koppanybme/rc-plane/media/board_assembled.jpg

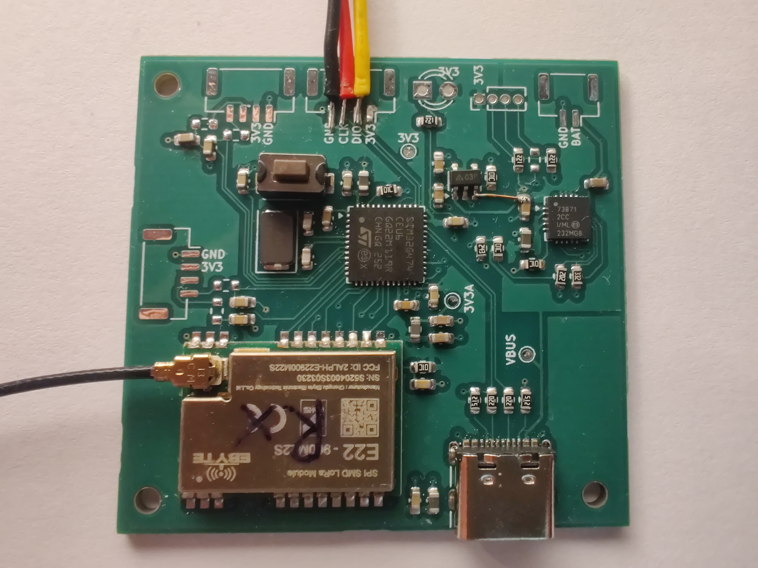
media/board_assembled.jpg
