koppanybme/rc-plane/media/IMG_20250505_191543.jpg

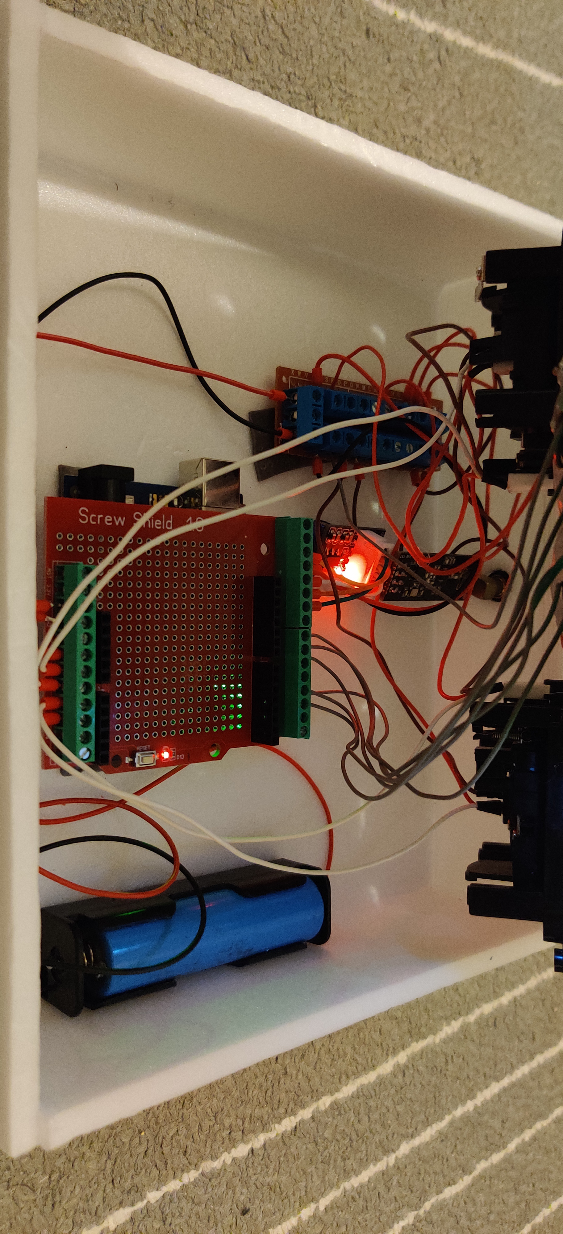
media/IMG_20250505_191543.jpg
