koppanybme/rc-plane/docs/readme.md

Overview

This project aims to create a flight controller for a fixed wing UAV.

History

v0.0 Arduino project using nRF24 (discontinued)
control and telemetry working, tested at 550 m range, video available

v0.1 STM32F103 migration (source code available)
only control implemented, no telemetry

v1.0 STM32G474 SX1262 (CAD files available)
board bringup successful
firmware under developement
