koppanybme/rc-plane/docs/tx_0dbm.png

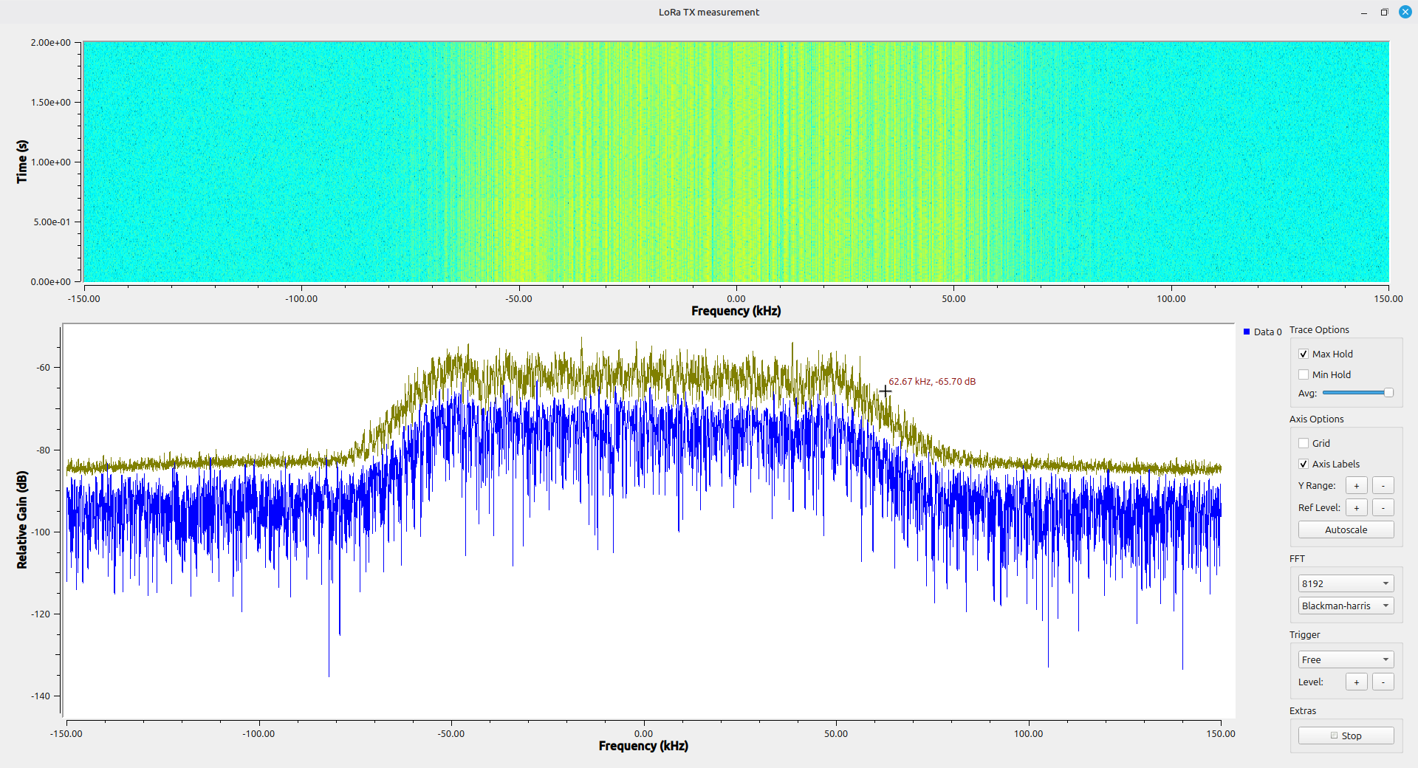
docs/tx_0dbm.png
