koppanybme/rc-plane/media/IMG_20250505_191519.jpg

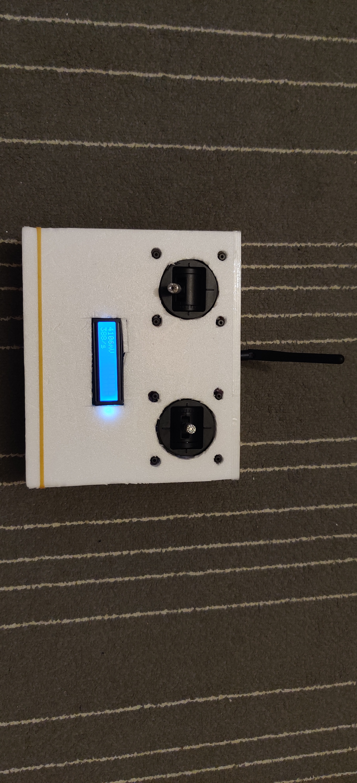
media/IMG_20250505_191519.jpg
