koppanybme/rc-plane/kicad/rc_plane_v1.0/manufacture/rc_plane_v1.0-F_Silkscreen.pdf

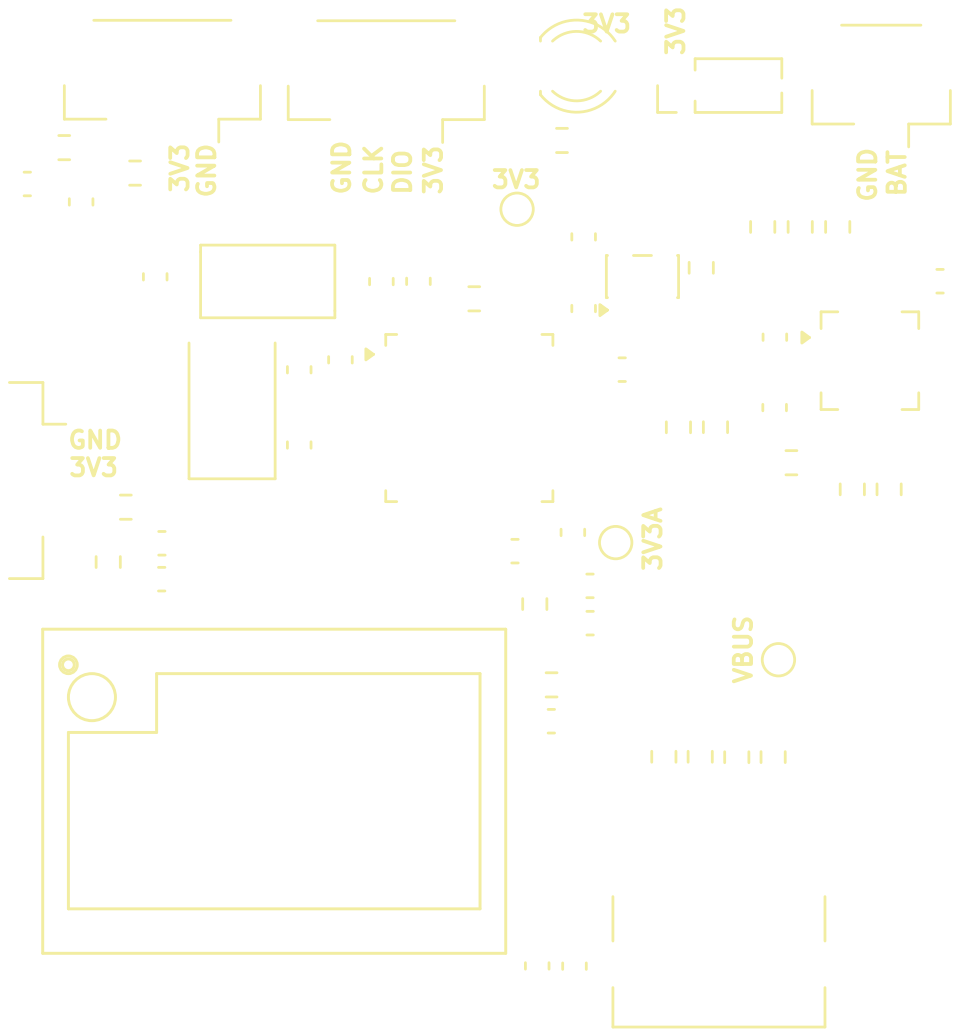
[picture p9: page 1]

3V3 GND DIO BAT GND CLK
