koppanybme/rc-plane/kicad/rc_plane_v1.0/manufacture/rc_plane_v1.0.pdf

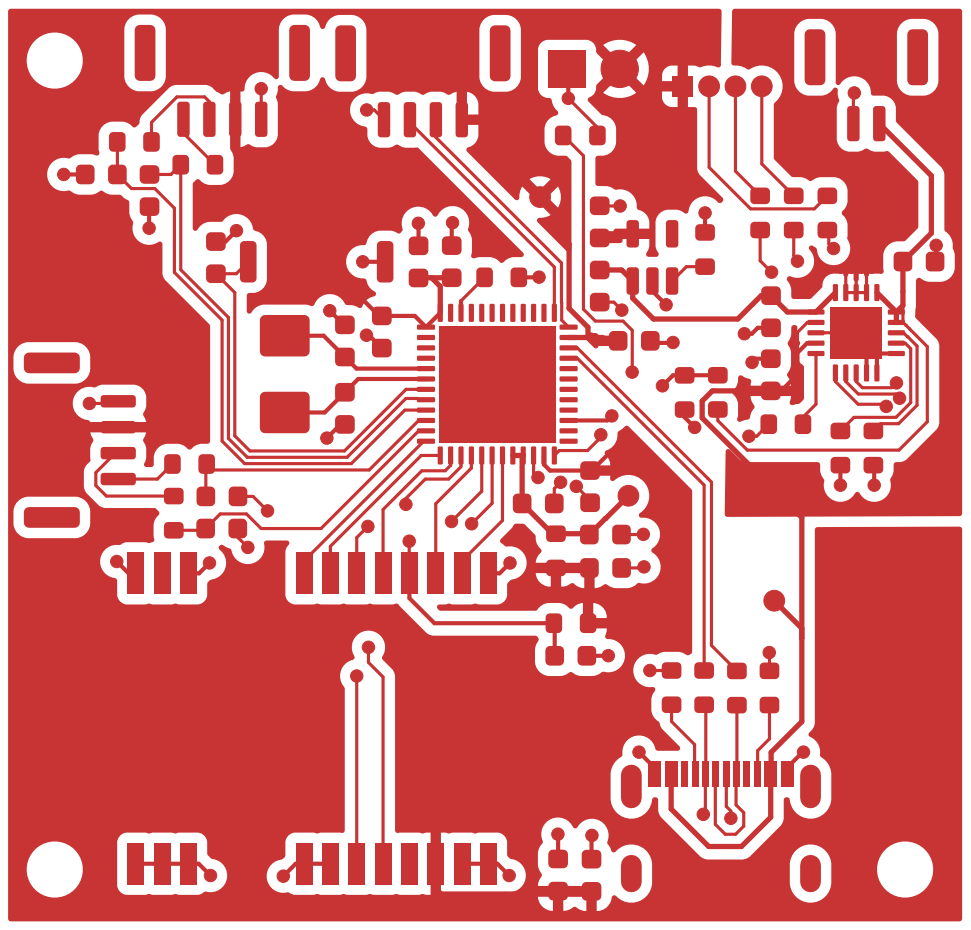
[picture p10: page 1]

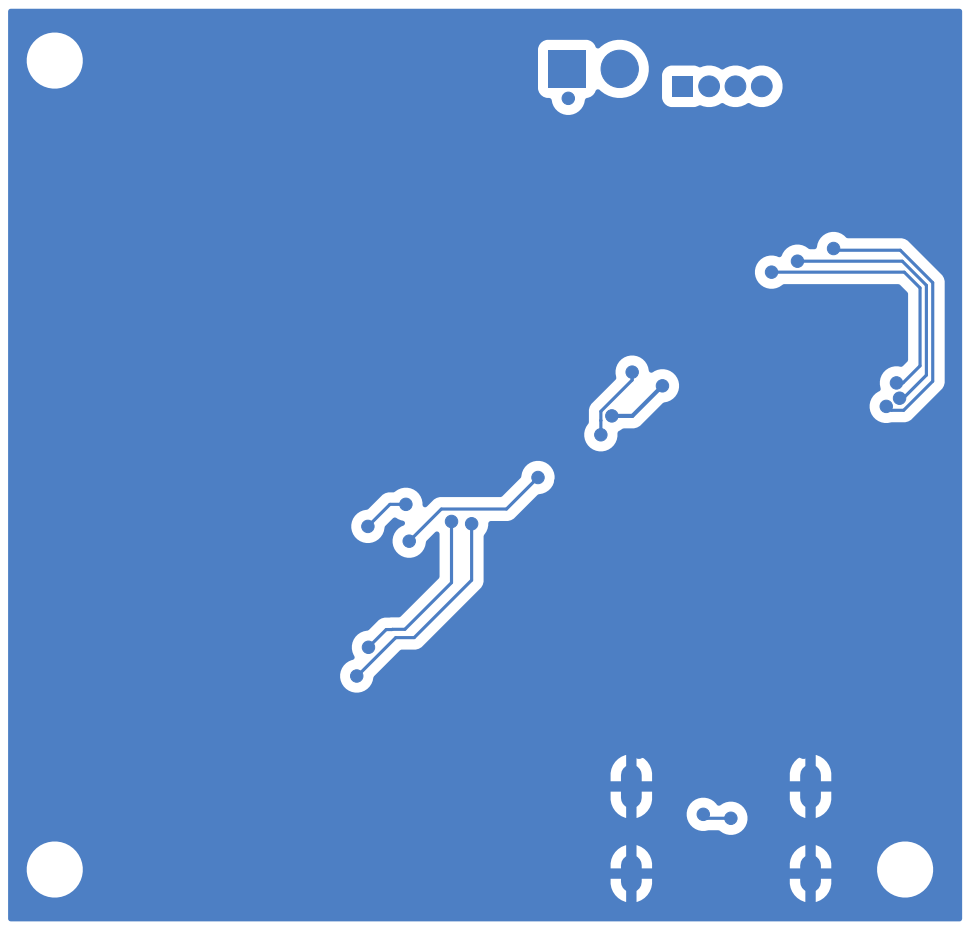
[picture p11: page 2]


3V3 GND DIO BAT GND CLK
