koppanybme/rc-plane/kicad/rc_plane_v1.0/rc_plane_v1.0.kicad_pcb

## KiCad design kicad/rc_plane_v1.0/rc_plane_v1.0.kicad_pcb (2026-07-08)

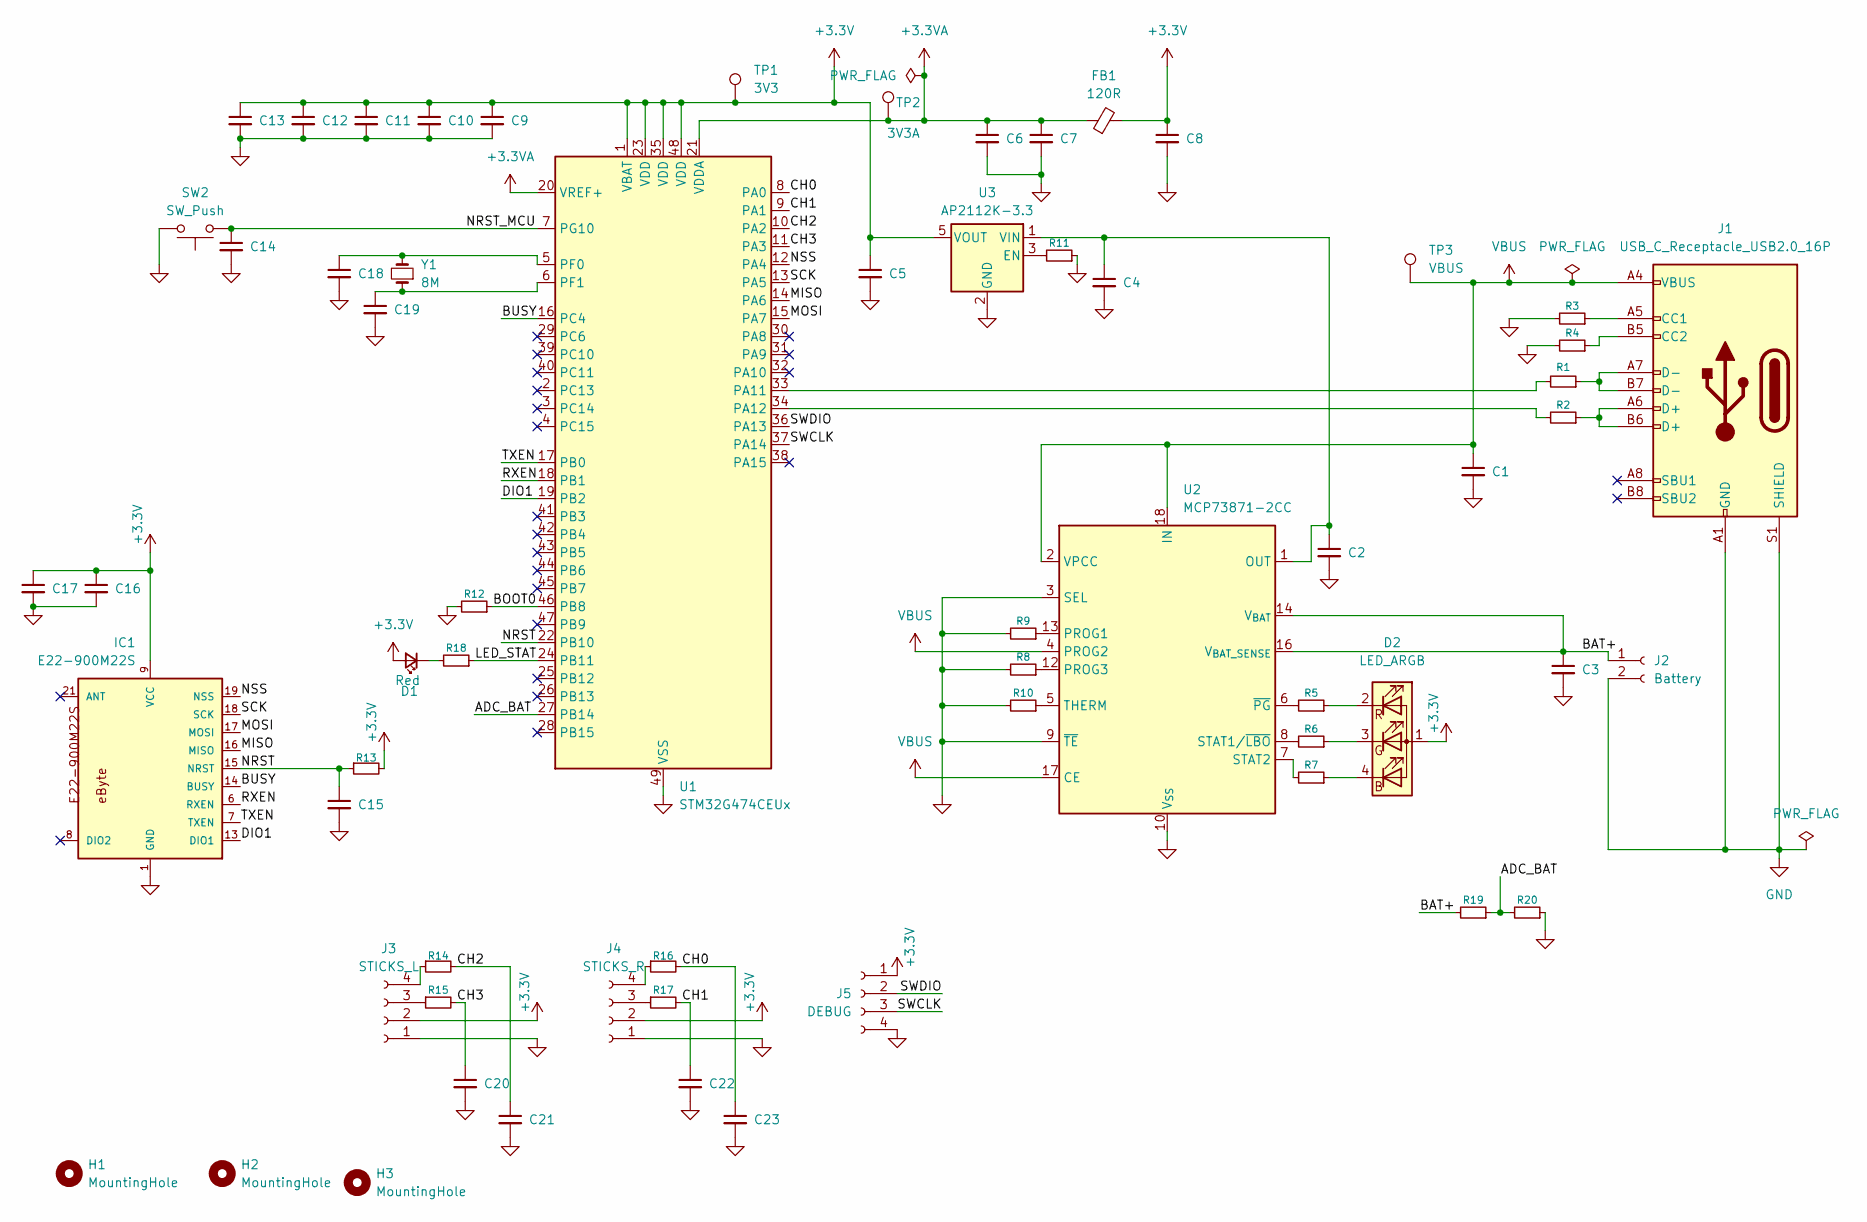
[picture p12: schematic rc_plane_v1.0.kicad_sch]

Parts:
C1, C13, C17: 10u; C_0603_1608Metric
C2, C3: 4.7u; C_0603_1608Metric
C4, C5, C7, C8: 1u; C_0603_1608Metric
C6: 10n; C_0603_1608Metric
C9, C10, C11, C12, C14, C15, C16, C20, C21, C22, C23: 100n; C_0603_1608Metric
C18, C19: 15p; C_0603_1608Metric
D1: Red; LED_D3.0mm
D2: LED_ARGB; PinHeader_1x04_P1.27mm_Vertical
FB1: 120R; R_0603_1608Metric
H1, H2, H3: MountingHole; MountingHole_2.2mm_M2
IC1: E22-900M22S
J1: USB_C_Receptacle_USB2.0_16P; USB_C_Receptacle_G-Switch_GT-USB-7010ASV
J2: Battery; JST_GH_SM02B-GHS-TB_1x02-1MP_P1.25mm_Horizontal
J3: STICKS_L; JST_GH_SM04B-GHS-TB_1x04-1MP_P1.25mm_Horizontal
J4: STICKS_R; JST_GH_SM04B-GHS-TB_1x04-1MP_P1.25mm_Horizontal
J5: DEBUG; JST_GH_SM04B-GHS-TB_1x04-1MP_P1.25mm_Horizontal
R1, R2: 22; R_0603_1608Metric
R3, R4: 5.1k; R_0603_1608Metric
R5, R6, R18: 220; R_0603_1608Metric
R7: 18; R_0603_1608Metric
R8: 2k; R_0603_1608Metric
R9: 3.3k; R_0603_1608Metric
R10, R11, R12, R13, R19: 10k; R_0603_1608Metric
R14, R15, R16, R17: 100; R_0603_1608Metric
R20: 24k; R_0603_1608Metric
SW2: SW_Push; SW_Push_6.0_3.5_MPTSM
TP1: 3V3; TestPoint_Pad_D1.0mm
TP2: 3V3A; TestPoint_Pad_D1.0mm
TP3: VBUS; TestPoint_Pad_D1.0mm
U1: STM32G474CEUx; QFN-48-1EP_7x7mm_P0.5mm_EP5.6x5.6mm
U2: MCP73871-2CC; QFN-20-1EP_4x4mm_P0.5mm_EP2.5x2.5mm
U3: AP2112K-3.3; SOT-23-5
Y1: 8M; Crystal_SMD_5032-2Pin_5.0x3.2mm

Connections:
+3.3V: C5.1, C8.1, C9.1, C10.1, C11.1, C12.1, C13.1, C16.1, C17.1, D1.2 (A), D2.1 (A), FB1.2, IC1.9 (VCC), J3.2, J4.2, J5.1, R13.2, TP1.1, U1.1 (VBAT), U1.23 (VDD), U1.35 (VDD), U1.48 (VDD), U3.5 (VOUT)
+3.3VA: C6.1, C7.1, FB1.1, TP2.1, U1.20 (VREF+), U1.21 (VDDA)
/ADC_BAT: R19.1, R20.2, U1.27 (PB14)
/BAT+: C3.1, J2.1, R19.2, U2.14 (V_{BAT}), U2.15 (V_{BAT}), U2.16 (V_{BAT_SENSE})
/BOOT0: R12.1, U1.46 (PB8)
/BUSY: IC1.14 (BUSY), U1.16 (PC4)
/CH0: C23.1, R16.2, U1.8 (PA0)
/CH1: C22.1, R17.2, U1.9 (PA1)
/CH2: C21.1, R14.2, U1.10 (PA2)
/CH3: C20.1, R15.2, U1.11 (PA3)
/DIO1: IC1.13 (DIO1), U1.19 (PB2)
/LED_STAT: R18.1, U1.24 (PB11)
/MISO: IC1.16 (MISO), U1.14 (PA6)
/MOSI: IC1.17 (MOSI), U1.15 (PA7)
/NRST: C15.1, IC1.15 (NRST), R13.1, U1.22 (PB10)
/NRST_MCU: C14.1, SW2.1, U1.7 (PG10)
/NSS: IC1.19 (NSS), U1.12 (PA4)
/RXEN: IC1.6 (RXEN), U1.18 (PB1)
/SCK: IC1.18 (SCK), U1.13 (PA5)
/SWCLK: J5.3, U1.37 (PA14)
/SWDIO: J5.2, U1.36 (PA13)
/TXEN: IC1.7 (TXEN), U1.17 (PB0)
GND: C1.2, C2.2, C3.2, C4.2, C5.2, C6.2, C7.2, C8.2, C9.2, C10.2, C11.2, C12.2, C13.2, C14.2, C15.2, C16.2, C17.2, C18.2, C19.2, C20.2, C21.2, C22.2, C23.2, IC1.1 (GND), IC1.2 (GND), IC1.3 (GND), IC1.4 (GND), IC1.5 (GND), IC1.10 (GND), IC1.11 (GND), IC1.12 (GND), IC1.20 (GND), IC1.22 (GND), J1.A1 (GND), J1.A12 (GND), J1.B1 (GND), J1.B12 (GND), J1.S1 (SHIELD), J2.2, J3.1, J4.1, J5.4, R3.2, R4.2, R8.2, R9.2, R10.2, R11.1, R12.2, R20.1, SW2.2, U1.49 (VSS), U2.3 (SEL), U2.9 (~TE), U2.10 (V_{SS}), U2.11 (V_{SS}), U2.21 (V_{SS}), U3.2 (GND)
unnamed: D1.1 (K), R18.2
unnamed: D2.4 (BK), R7.1
unnamed: D2.3 (GK), R6.1
unnamed: D2.2 (RK), R5.1
unnamed: J1.A5 (CC1), R3.1
unnamed: J1.B5 (CC2), R4.1
unnamed: J1.A6 (D+), J1.B6 (D+), R2.1
unnamed: J1.A7 (D-), J1.B7 (D-), R1.1
unnamed: J3.3, R15.1
unnamed: J3.4, R14.1
unnamed: J4.3, R17.1
unnamed: J4.4, R16.1
unnamed: R1.2, U1.33 (PA11)
unnamed: R2.2, U1.34 (PA12)
unnamed: C18.1, U1.5 (PF0), Y1.2
unnamed: C19.1, U1.6 (PF1), Y1.1
unnamed: R9.1, U2.13 (PROG1)
unnamed: R8.1, U2.12 (PROG3)
unnamed: R6.2, U2.8 (STAT1/~LBO)
unnamed: R7.2, U2.7 (STAT2)
unnamed: R10.1, U2.5 (THERM)
unnamed: R5.2, U2.6 (~PG)
unnamed: R11.2, U3.3 (EN)
unnamed: C2.1, C4.1, U2.1 (OUT), U2.20 (OUT), U3.1 (VIN)
VBUS: C1.1, J1.A4 (VBUS), J1.A9 (VBUS), J1.B4 (VBUS), J1.B9 (VBUS), TP3.1, U2.2 (VPCC), U2.4 (PROG2), U2.17 (CE), U2.18 (IN), U2.19 (IN)

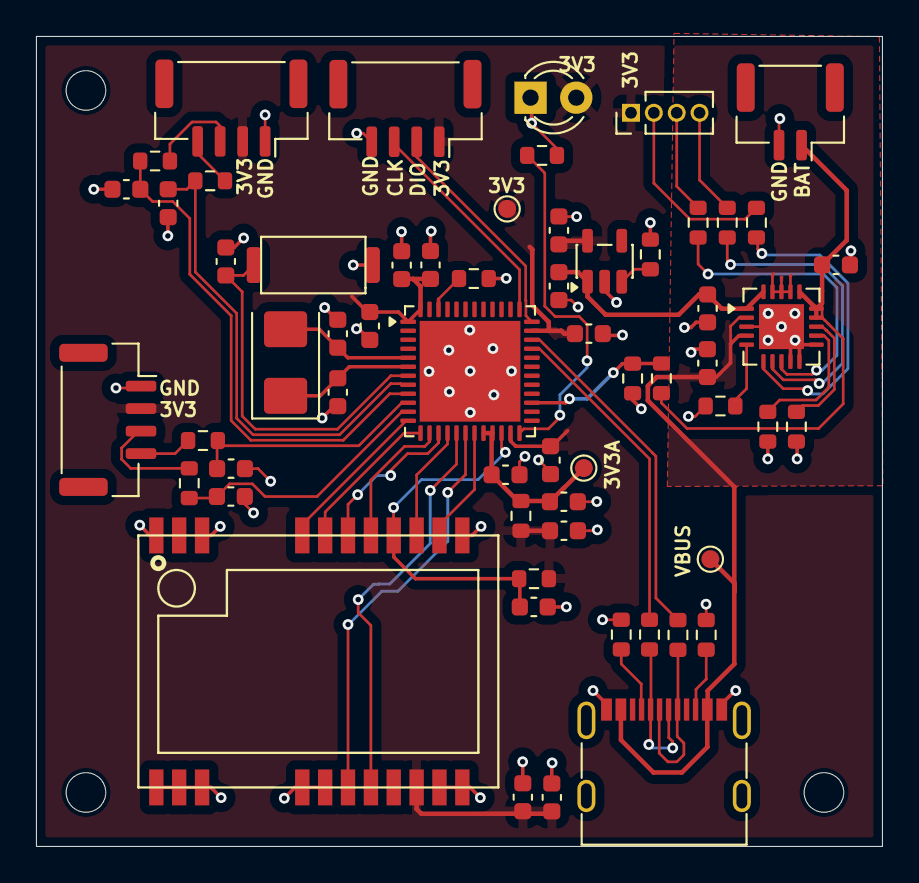
[picture p13: board rc_plane_v1.0.kicad_pcb from above]

Board: 2 copper layers, 47.0 x 45.0 mm, 63 parts (0 on the bottom side), 48 nets.
