koppanybme/rc-plane/STM32/nrf24_transmitter/Core/Src/main.c

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
/* Includes ------------------------------------------------------------------*/
#include "main.h"
#include "adc.h"
#include "dma.h"
#include "spi.h"
#include "tim.h"
#include "gpio.h"

/* USER CODE BEGIN Includes */
#include "nrf24.h"
/* USER CODE END Includes */

/* USER CODE BEGIN PD */
#define JOYSTICK_DEADZONE 25
/* USER CODE END PD */


/* USER CODE BEGIN PV */
static uint8_t txSerialized[32];
volatile uint32_t adc_results[4];

//Hardcoded values for now
static uint16_t aileron_raw_min = 692;
static uint16_t aileron_raw_middle = 2158;
static uint16_t aileron_raw_max = 3562;
static uint16_t elevator_raw_min = 276;
static uint16_t elevator_raw_middle = 2047;
static uint16_t elevator_raw_max = 3562;
static uint16_t throttle_raw_min = 306;
static uint16_t throttle_raw_max = 3368;
static uint16_t rudder_raw_min = 581;
static uint16_t rudder_raw_middle = 2045;
static uint16_t rudder_raw_max = 3549;
/* USER CODE END PV */

void SystemClock_Config(void);
/* USER CODE BEGIN PFP */
uint16_t mapChannel(uint16_t raw, uint16_t min, uint16_t middle, uint16_t max, uint8_t is_throttle, uint8_t is_reversed);
/* USER CODE END PFP */

/**
  * @brief  The application entry point.
  * @retval int
  */
int main(void)
{

  /* MCU Configuration--------------------------------------------------------*/

  /* Reset of all peripherals, Initializes the Flash interface and the Systick. */
  HAL_Init();

  /* USER CODE BEGIN Init */
  for(int i = 0; i<32; i++) txSerialized[i] = i;
  /* USER CODE END Init */

  /* Configure the system clock */
  SystemClock_Config();

  /* Initialize all configured peripherals */
  MX_GPIO_Init();
  MX_DMA_Init();
  MX_SPI2_Init();
  MX_TIM2_Init();
  MX_ADC1_Init();
  /* USER CODE BEGIN 2 */
  HAL_ADCEx_Calibration_Start(&hadc1);
  HAL_ADC_Start_DMA(&hadc1, (uint32_t*)adc_results, 4);
  NRF24_Init(0);
  uint8_t status = NRF24_ReadReg(NRF24_REG_STATUS);
  uint8_t ch = NRF24_ReadReg(NRF24_REG_RF_CH);
  HAL_TIM_Base_Start_IT(&htim2);
  TIM2->CCR2 = 3900;	//Every ADC conversion starts 100us before transmitting
  HAL_TIM_PWM_Start(&htim2, TIM_CHANNEL_2);

  /* USER CODE END 2 */

  /* Infinite loop */
  /* USER CODE BEGIN WHILE */
  while (1)
  {
    /* USER CODE END WHILE */

    /* USER CODE BEGIN 3 */
	  volatile uint32_t ch0 = adc_results[0];
	  volatile uint32_t ch1 = adc_results[1];
	  volatile uint32_t ch2 = adc_results[2];
	  volatile uint32_t ch3 = adc_results[3];
  }
  /* USER CODE END 3 */
}

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
/* USER CODE BEGIN 4 */
void HAL_TIM_PeriodElapsedCallback(TIM_HandleTypeDef *htim)
{
    if (htim->Instance == TIM2) {
        // This runs at 250 Hz
        uint32_t time = HAL_GetTick();
        //Serialize time MSB first
        txSerialized[0] = (time & 0xff000000) >> 24;
        txSerialized[1] = (time & 0x00ff0000) >> 16;
        txSerialized[2] = (time & 0x0000ff00) >> 8;
        txSerialized[3] = (time & 0x000000ff) >> 0;
        NRF24_Transmit_IT(txSerialized, 32);
    }
}
void HAL_ADC_ConvCpltCallback(ADC_HandleTypeDef* hadc)
{
	uint16_t aileron = mapChannel(adc_results[0], aileron_raw_min, aileron_raw_middle, aileron_raw_max, 0, 0);
	uint16_t elevator = mapChannel(adc_results[1], elevator_raw_min, elevator_raw_middle, elevator_raw_max, 0, 0);
	uint16_t throttle = mapChannel(adc_results[2], throttle_raw_min, throttle_raw_min, throttle_raw_max, 1, 0);
	uint16_t rudder = mapChannel(adc_results[3], rudder_raw_min, rudder_raw_middle, rudder_raw_max, 0, 0);
	//Serialize adc results MSB first
	txSerialized[4] = aileron >> 8;
	txSerialized[5] = aileron & 0xff;
	txSerialized[6] = elevator >> 8;
	txSerialized[7] = elevator & 0xff;
	txSerialized[8] = throttle >> 8;
	txSerialized[9] = throttle & 0xff;
	txSerialized[10] = rudder >> 8;
	txSerialized[11] = rudder & 0xff;
}
uint16_t mapChannel(uint16_t raw, uint16_t min, uint16_t middle, uint16_t max, uint8_t is_throttle, uint8_t is_reversed){
	if(min >= max || middle >= max) return 2048;
	if (raw <= min) raw = min;
	if (raw >= max) raw = max;
	uint16_t normalized = 0;
	if(is_throttle){
		uint16_t range = max-min;
		normalized = (uint32_t)(raw-min)*4095/range;
	} else {
		if(raw > middle-JOYSTICK_DEADZONE && raw <= middle+JOYSTICK_DEADZONE){
			//If inside deadzone
			return 2048;
		} else if(raw <= middle-JOYSTICK_DEADZONE){
			//Map linearly to lower half
			uint16_t range = middle-min-JOYSTICK_DEADZONE;
			normalized = (uint32_t)(raw-min)*2048/range;
		} else{
			//Map linearly to upper half
			uint16_t range = max-middle-JOYSTICK_DEADZONE;
			normalized = 2047+(uint32_t)(raw-middle-JOYSTICK_DEADZONE)*2048/range;
		}
	}
	if(is_reversed){
		normalized = 4095 - normalized;
	}
	return (uint16_t)normalized;
}
/* USER CODE END 4 */
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
