koppanybme/rc-plane/STM32/nrf24_transmitter/nrf24_transmitter.ioc

Mcu.UserName=STM32F103C8Tx
PA0-WKUP.Signal=ADCx_IN0
PA1.Signal=ADCx_IN1
PA13.Signal=SYS_JTMS-SWDIO
PA14.Signal=SYS_JTCK-SWCLK
PA2.Signal=ADCx_IN2
PA3.Signal=ADCx_IN3
PA8.GPIO_Label=SPI2_CSN
PA8.Signal=GPIO_Output
PA9.GPIO_Label=NRF24_CE
PA9.Signal=GPIO_Output
PB12.GPIO_Label=NRF24_IRQ
PB12.Signal=GPXTI12
PB13.Signal=SPI2_SCK
PB14.Signal=SPI2_MISO
PB15.Signal=SPI2_MOSI
PD0-OSC_IN.Signal=RCC_OSC_IN
PD1-OSC_OUT.Signal=RCC_OSC_OUT
