koppanybme/rc-plane/STM32/nrf24_receiver/Core/Inc/main.h

#define NRF24_IRQ_Pin GPIO_PIN_12
#define NRF24_IRQ_GPIO_Port GPIOB
#define NRF24_IRQ_EXTI_IRQn EXTI15_10_IRQn
#define SPI2_CSN_Pin GPIO_PIN_8
#define SPI2_CSN_GPIO_Port GPIOA
#define NRF24_CE_Pin GPIO_PIN_9
#define NRF24_CE_GPIO_Port GPIOA
