koppanybme/rc-plane/Arduino/receiver/receiver.ino

#include <SPI.h>
#include <nRF24L01.h>
#include <RF24.h>
#include <Servo.h>

int ch_width_1 = 0;
int ch_width_2 = 0;
int ch_width_3 = 0;
int ch_width_4 = 0;
int ch_width_5 = 0;
int ch_width_6 = 0;
int ch_width_7 = 0;
int ch_width_8 = 0;

Servo ch1;
Servo ch2;
Servo ch3;
Servo ch4;
Servo ch5;
Servo ch6;
Servo ch7;
Servo ch8;

struct Signal {
  byte throttle;
  byte pitch;  
  byte roll;
  byte yaw;
  byte aux1;
  byte aux2;
  byte aux3;
  byte aux4;     
};

struct Telemetry {
  uint16_t id;
  uint16_t bat;
};

Signal data;
Telemetry telemetry;

const uint64_t pipeIn = 000322;
const uint64_t pipeOut = 000321;
RF24 radio(9, 10); 

void ResetData()
{
  data.throttle = 0;
  data.roll = 127;
  data.pitch = 127;
  data.yaw = 127;
  data.aux1 = 0;
  data.aux2 = 0;
  data.aux3 = 0;
  data.aux4 = 0;                                                     
}

void GetTelemetry()
{
  telemetry.id++;
  telemetry.bat = analogRead(A0);
}

void setup()
{
  //Serial.begin(9600);
  ch1.attach(0);
  ch2.attach(2);
  ch3.attach(3);
  ch4.attach(4);
  ch5.attach(5);
  ch6.attach(6);
  ch7.attach(7);
  ch8.attach(8);
                                                           
  ResetData();
  radio.begin();
  radio.openReadingPipe(1,pipeIn);
  radio.openWritingPipe(pipeOut);
  radio.setChannel(109);
  radio.enableDynamicPayloads();
  radio.enableAckPayload();
  radio.setDataRate(RF24_250KBPS);
  radio.setPALevel(RF24_PA_MAX);
  radio.startListening();
  Serial.println("hello");
}

unsigned long lastRecvTime = 0;
uint16_t recieved = 0;
unsigned long measureStart = millis();

void recvData()
{
  while ( radio.available() ) {
    GetTelemetry();
    radio.writeAckPayload(1, &telemetry, sizeof(telemetry));
    radio.read(&data, sizeof(Signal));
    lastRecvTime = millis();
    recieved++;
  }
}

void loop()
{
  recvData();
  
  unsigned long now = millis();
  if(now - measureStart >= 1000){
    //Serial.println(recieved);
    measureStart = millis();
    recieved = 0;
  }
  if ( now - lastRecvTime > 1000 ) {
    ResetData();
  }
  ch_width_1 = map(data.roll, 0, 255, 1389, 1611);
  ch_width_2 = map(data.pitch, 0, 255, 1222, 1833);
  ch_width_3 = map(data.throttle, 0, 255, 1000, 2000);
  ch_width_4 = map(data.yaw, 0, 255, 900, 2000);
  ch_width_5 = map(data.aux1, 0, 255, 1000, 2000);
  ch_width_6 = map(data.aux2, 0, 255, 1000, 2000);
  ch_width_7 = map(data.aux3, 0, 1, 1000, 2000);
  ch_width_8 = map(data.aux4, 0, 1, 1000, 2000);

  ch1.writeMicroseconds(ch_width_1);
  ch2.writeMicroseconds(ch_width_2);
  ch3.writeMicroseconds(ch_width_3);
  ch4.writeMicroseconds(ch_width_4);
  ch5.writeMicroseconds(ch_width_5);
  ch6.writeMicroseconds(ch_width_6);                          
  ch7.writeMicroseconds(ch_width_7);
  ch8.writeMicroseconds(ch_width_8);
}
