koppanybme/rc-plane/(commit log)

2025-07-17 transmitter lcd working, typo fix
    [receiver.ino, transmitter.ino]
2025-09-13 Added NRF24 driver for STM32 //TODO async spi, implement all radio commands
2025-09-17 implemented 4 channel servo control //TODO async spi, two-way communication
2025-11-13 Implemented joystick calibration Implemented signal lost behaviour
2026-07-08 Added kicad project Added initial docs (TBC)
    [.kicad_sch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]
