koppanybme/rc-plane/(notices)

Notices in the files:
STM32/nrf24_receiver/Core/Src/tim.c:
Copyright (c) 2025 STMicroelectronics.
All rights reserved.
This software is licensed under terms that can be found in the LICENSE file
